dagoodma/SLUGS-Logger/Hardware/SLogger.brd

## EAGLE design Hardware/SLogger.brd (2015-04-01)

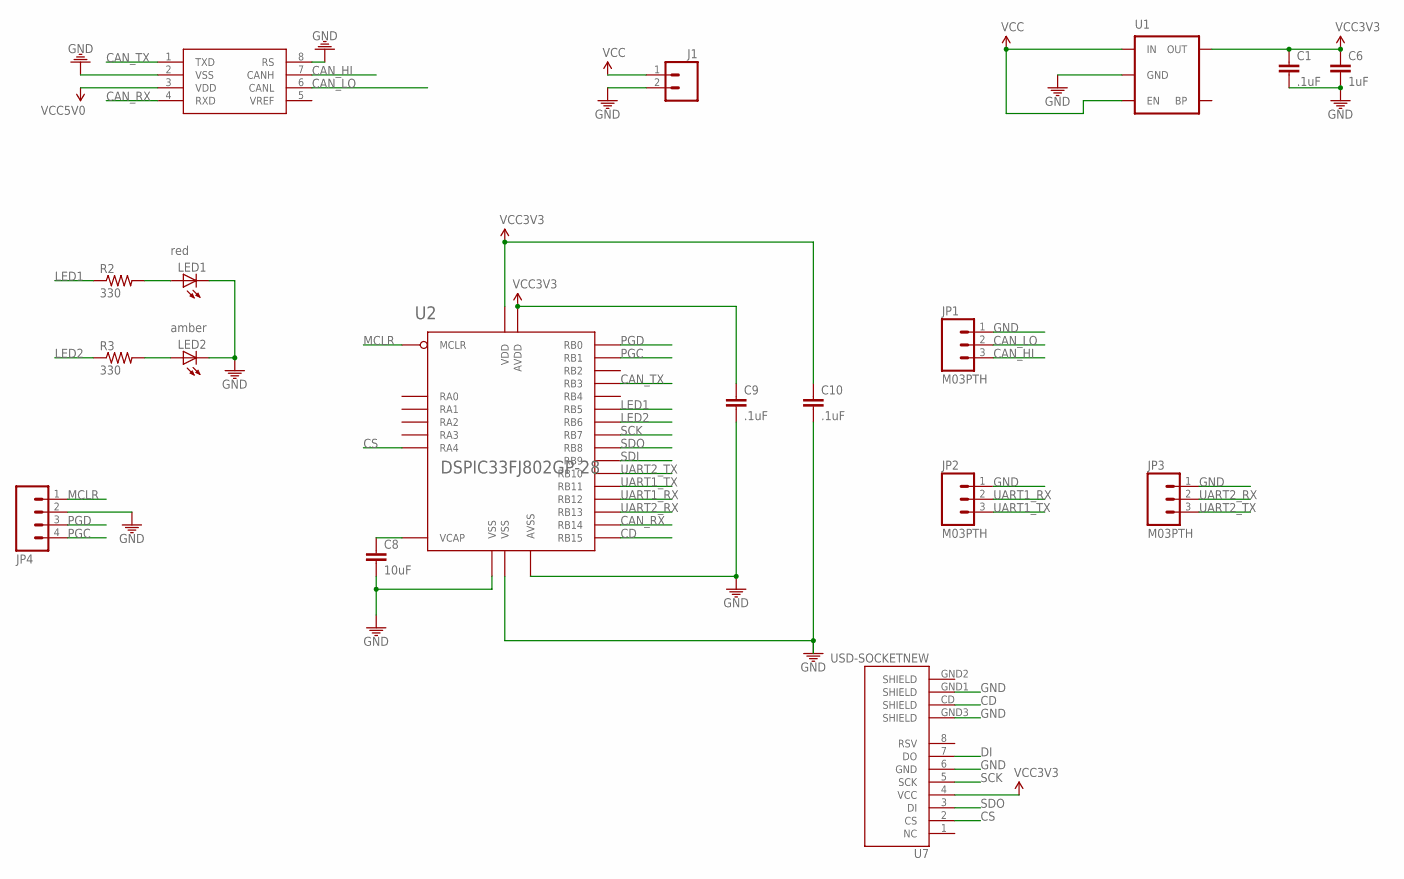
[picture p2: schematic SLogger.sch]

Parts:
C1, C9, C10: .1uF; 0805
C6: 1uF; 0805
C8: 10uF; 0805
J1: M02PTH; 1X02
JP1, JP2, JP3: M03PTH; 1X03
JP4: M04PTH; 1X04
LED1, LED2: LED0805; LED-0805
R2, R3: 330; 0805
U1: MIC52053.3V; SOT23-5
U2: DSPIC33FJ802GP-28; SOIC28-W
U4: MCP2551; SO08
U7: USD-SOCKETNEW; MICRO-SD-SOCKET-PP

Connections:
CAN_HI: JP1.3, U4.7 (CANH)
CAN_LO: JP1.2, U4.6 (CANL)
CAN_RX: U2.P$25 (RB14), U4.4 (RXD)
CAN_TX: U2.P$7 (RB3), U4.1 (TXD)
CD: U2.P$26 (RB15), U7.CD (SHIELD)
CS: U2.P$12 (RA4), U7.2 (CS)
DI: U7.7 (DO)
GND: C1.2, C6.2, C8.2, C9.2, C10.2, J1.2 (1), JP1.1, JP2.1, JP3.1, JP4.2, LED1.2 (C), LED2.2 (C), U1.2 (GND), U2.P$8 (VSS), U2.P$19 (VSS), U2.P$27 (AVSS), U4.2 (VSS), U4.8 (RS), U7.6 (GND), U7.GND1 (SHIELD), U7.GND3 (SHIELD)
LED1: R2.1, U2.P$14 (RB5)
LED2: R3.1, U2.P$15 (RB6)
MCLR: JP4.1, U2.P$1 (MCLR)
unnamed: LED1.1 (A), R2.2
unnamed: LED2.1 (A), R3.2
unnamed: C8.1, U2.P$20 (VCAP)
PGC: JP4.4, U2.P$5 (RB1)
PGD: JP4.3, U2.P$4 (RB0)
SCK: U2.P$16 (RB7), U7.5 (SCK)
SDI: U2.P$18 (RB9)
SDO: U2.P$17 (RB8), U7.3 (DI)
UART1_RX: JP2.2, U2.P$23 (RB12)
UART1_TX: JP2.3, U2.P$22 (RB11)
UART2_RX: JP3.2, U2.P$24 (RB13)
UART2_TX: JP3.3, U2.P$21 (RB10)
VCC: J1.1 (2), U1.1 (IN), U1.3 (EN)
VCC3V3: C1.1, C6.1, C9.1, C10.1, U1.5 (OUT), U2.P$13 (VDD), U2.P$28 (AVDD), U7.4 (VCC)
VCC5V0: U4.3 (VDD)

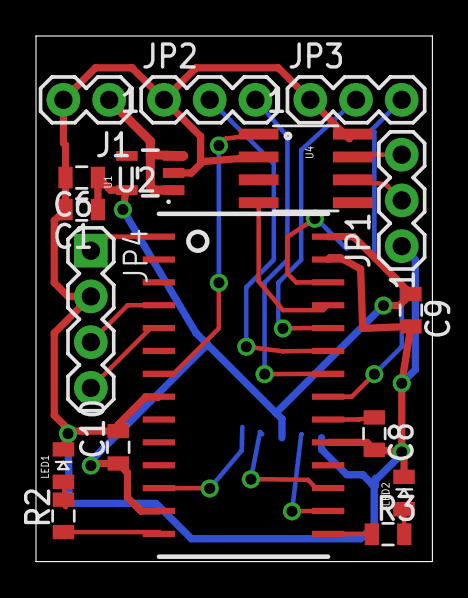
[picture p3: board SLogger.brd from above]

Board: 2 copper layers, 22.0 x 29.2 mm, 18 parts (1 on the bottom side), 23 nets.
