dagoodma/SLUGS-Logger/Testing/README.txt

Various test files:
beotest.txt - A few minutes to transmit @ 115200baud. Good initial test.
beotest_*sectors.txt - For debugging specific problems.
LotsOfLiterature.txt - Takes ~30 minutes to transmit at 115200 baud. If this works well, chances are the datalogger will work fine.
