dagoodma/SLUGS-Logger/HardwareProfile.h

/******************************************************************************
 *
 *                Microchip Memory Disk Drive File System
 *
 ******************************************************************************
 * FileName:        HardwareProfile.h
 * Dependencies:    None
 * Processor:       PIC18/PIC24/dsPIC30/dsPIC33/PIC32
 * Compiler:        C18/C30/C32
 * Company:         Microchip Technology, Inc.
 *
 * Software License Agreement
 *
 * The software supplied herewith by Microchip Technology Incorporated
 * (the ?Company?) for its PICmicro? Microcontroller is intended and
 * supplied to you, the Company?s customer, for use solely and
 * exclusively on Microchip PICmicro Microcontroller products. The
 * software is owned by the Company and/or its supplier, and is
 * protected under applicable copyright laws. All rights are reserved.
 * Any use in violation of the foregoing restrictions may subject the
 * user to criminal sanctions under applicable laws, as well as to
 * civil liability for the breach of the terms and conditions of this
 * license.
 *
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
*****************************************************************************/
/********************************************************************
 Change History:
  Rev            Description
  ----           -----------------------
  1.3.4          Added support for PIC18F8722,PIC24FJ256DA210,
                 dsPIC33E & PIC24E microcontrollers.
                 Added macro "SPI_INTERRUPT_FLAG_ASM" for PIC18F
                 microcontrollers to support SD card SPI driver.
********************************************************************/

#ifndef HARDWAREPROFILE_H_
#define HARDWAREPROFILE_H_

// Make sure Microchip's libraries know they're using the SPI-SD interface
#define USE_SD_INTERFACE_WITH_SPI

#if defined (__dsPIC33E__) || defined (__PIC24E__)

    #define GetSystemClock()        80000000
    #define GetPeripheralClock()    (GetSystemClock() / 2)
    #define GetInstructionClock()   (GetSystemClock() / 2)

    // Description: SD-SPI Chip Select Output bit
    #define SD_CS               PORTBbits.RB0
    // Description: SD-SPI Chip Select TRIS bit
    #define SD_CS_TRIS          TRISBbits.TRISB0

    // Description: SD-SPI Analog/Digital Select ANSEL bit
    #define SD_CS_ANSEL		0   //ANSELBbits.ANSB9

    // Description: SD-SPI Card Detect Input bit
    // The state of the SD card, 0 means that the SD card is inserted.
    #define SD_CD               PORTAbits.RA0
    // Description: SD-SPI Card Detect TRIS bit
    #define SD_CD_TRIS          TRISAbits.TRISA0

    // Description: SD-SPI Write Protect Check Input bit
    #define SD_WE               0
    // Description: SD-SPI Write Protect Check TRIS bit
    #define SD_WE_TRIS          TRISAbits.TRISA2

    // Description: SD-SPI Analog/Digital Select ANSEL bit
    #define SD_SCK_ANSEL	0   //ANSELGbits.ANSG6
    #define SD_SDI_ANSEL	0   //ANSELGbits.ANSG7
    #define SD_SDO_ANSEL	0   //ANSELGbits.ANSG8

    // Description: The main SPI control register
    #define SPICON1             SPI2CON1
    // Description: The SPI status register
    #define SPISTAT             SPI2STAT
    // Description: The SPI Buffer
    #define SPIBUF              SPI2BUF
    // Description: The receive buffer full bit in the SPI status register
    #define SPISTAT_RBF         SPI2STATbits.SPIRBF
    // Description: The bitwise define for the SPI control register (i.e. _____bits)
    #define SPICON1bits         SPI2CON1bits
    // Description: The bitwise define for the SPI status register (i.e. _____bits)
    #define SPISTATbits         SPI2STATbits
    // Description: The enable bit for the SPI module
    #define SPIENABLE           SPI2STATbits.SPIEN
    // Description: The definition for the SPI baud rate generator register
    #define SPIBRG              0 // SPI2BRG

    // Tris pins for SCK/SDI/SDO lines

    // Description: The TRIS bit for the SCK pin
    #define SPICLOCK            TRISBbits.TRISB9
    // Description: The TRIS bit for the SDI pin
    #define SPIIN               TRISBbits.TRISB14
    // Description: The TRIS bit for the SDO pin
    #define SPIOUT              TRISBbits.TRISB8

#else

    #error Only the dsPIC33E/PIC24Es are supported with this hardware profile

#endif

#endif // HARDWAREPROFILE_H_
