dagoodma/SLUGS-Logger/(commit log)

2013-02-19 Getting used to UART. This does simply receive using DMA.
2013-02-19 Put UART init and interrupt into Uart2.c and Uart2.h
2013-02-19 Put DMA stuff with Uart2 library. DMA is now in ping-pong mode.
2013-02-19 Finished ping-pong buffer with user-defined interrupt func. Uart2Init() now takes a user-defined function pointer which is called when a pin-pong buffer is full. main.c has an example.
2013-02-22 Plugged old SPI and Filesystem stuff into new UART using OFBProxy to give Service_SPI() something to use.
2013-03-02 Added a single-shot sector-write function which does not currently work.
2013-03-05 NewSDWriteSector now works correctly. This easily allows writing a single sectors at a time to a file.
    [NewSDWrite.h, main.c]
2013-03-05 Added new SDWrite functions to more versatile. They don't currently work. Updated the todo list.
2013-03-05 NewSDWriteSector and NewSDInit now work correctly using the function NewFileUpdate which mimics FSfclose.
    [NewSDWrite.h, main.c]
2013-03-06 Reworked file orgnization, removed unused files, removed some unused functions.
    [main.c]
2013-03-06 More reworking of file system. Redownloaded Microchip lib and removed all old library code.
    [FSconfig.h, HardwareProfile.h, main.c]
2013-03-06 Implemented Bryant's circular buffer to work with the UART. It kinda works. Only writes up to 33kb.
2013-03-06 Still getting 33k error, now has debug code. Added debug folder with interesting UART output. Seems there is a problem transitioning between clusters.
    [main.c]
2013-03-07 33k bug is because of incorrect cluster switching.
2013-03-12 Fixed 33k bug - now correctly switches to a new cluster when needed.
2013-03-12 Can write continuously (tested 2.5 MB at full speed). Removing SD card causes all following writes to fail even if the card is put back.
    [main.c]
2013-03-15 Tested multiple times - each test had indentical errors. Now 38400 baud, removed some debug code.
    [main.c]
2013-03-15 Generates own data for putting on the circular buffer. Added more debug notes - a clear pattern was found. Not a problem with serial, DMA, or speed. See third debug note.
    [main.c]
2013-03-20 Continued testing to fix circular buffer bug - it is more complicated than expected. Created a python script to confirm a repeating text file.
    [main.c]
2013-04-01 Fixed circular buffer bug, added tests to verify.
    [main.c]
2013-04-08 Added checksums on the input and output of the circ buff. There is still a problem with reading from the circ buff.
    [main.c]
2013-04-10 Might have fixed the circular buffer problem. Lots of debug code to clean up.
    [main.c]
2013-04-15 Corrected the circular buffer size for a proper test.
    [main.c]
2013-04-26 Started implementing config file. Doesn't work.'
    [main.c]
2013-05-13 Fixed address/stack error when disconnecting card. Was dereferencing a null pointer. Now checks for null.
    [Traps.c, main.c]
2013-05-20 Now compiles for the CANode, but does not work, likely due to a mistake in the uSD shield.
    [HardwareProfile.h, main.c]
2013-06-03 Switched the test sender to a CANode, now everything works fine. Next: UART tests on the CANode.
2013-06-04 There seems to be problems with creating files with the correct names and with the device restarting when the 8GB card is inserted.
    [main.c]
2013-07-01 Opening files is having problems - I implemented basic EEPROM emulation.
    [main.c]
2013-07-02 File writing works with basic tests - file headers and footers are now correct.
    [main.c]
2013-07-30 UART works now
2013-08-02 Working on fixing the SPI pins.
    [HardwareProfile.h, main.c]
2013-08-02 SPI seems to work, removed some stuff that didn't need to be tracked.
    [main.c]
2013-08-06 Code is not working or debugging on the main project. Commiting before making drastic changes.
    [main.c]
2013-08-07 UART/DMA seems to work, testing now.
2013-08-08 Made buffer much smaller to hopefully keep the stack out of extended data space. DMA address error soft trap is triggering.
    [main.c]
2013-08-13 Added a doc and tried fixing some of the warnings.
    [main.c]
2013-08-14 Added an assembly file to put the stack in regular data space and changed Traps.c
2013-08-14 Increased the buffer and did a short test.
    [main.c]
2013-08-15 Isolated a bug with the DEE.
    [main.c]
2013-08-16 Added debug output over the UART, cleaned up some code, added to the REAME, and did a test.
2014-10-07 Hardware has inverted card detect signal.
    [HardwareProfile.h]
2014-10-07 Various improvements and cleanups. Red LED now works. Code is organized a little better. Some dead code removed.
2014-10-08 Remove old debugging code. Add LED status blinking.
    Now the amber LED turns off whenever data is received, for a brief point of time. This allows for simple debugging in the field: if the LED isn't blinking, the data isn't being received. And if the SD card isn't receiving files, then there's a problem with the output.
    [main.c]
2014-10-08 Light the red LED on startup until the card is initialized.
2014-11-04 Make UART2 pin assignment dependent on configuration settings.
2014-11-04 Only support a single SD-card pin layout.
2014-11-05 Allow for peripheral pin configuration multiple times.
2014-11-05 Replace FATAL_ERROR() macro with one that blinks the red LED.
    This makes it more clean when the startup LED is solid at startup and when it
    runs into a fatal error later on during initialization.
    [main.c]
2014-11-06 Add a delay when triggering on card insertion to make sure it's not a glitch.
    [main.c]
2014-11-06 Add Uart2Disable() function.
2014-11-06 Disable UART2 when the card is removed.
2014-11-06 Support logging metadata to an additional file.
    Preliminary support added for power-up and config settings.
    Also fix for improper const variable.
    [main.c]
2014-11-07 Add a .1s precision timer for logging events.
    And make sure the event trackers are reset everything the card is reinitialized.
    [main.c]
2014-11-07 Reorder initialization to prevent bufer overflow.
    [main.c]
2014-11-07 Log why a new log file was created.
    Currently tracking if it was a power-on event, card insertion, brown-out, manual reset, or a cat
    ch-all for other unknown events.
    [main.c]
2014-11-07 Remove infinite loops that can stall initialization from the SPI lib.
2014-11-07 Reduce timeout limit in the SPI library.
2014-11-07 Disable the UART when the SD card is removed.
2014-11-07 Change some FATAL_ERRORs into recoverable errors.
    Most errors should be reset once the SDcard is removed and reinserted.
    We just need to make sure that things are reset properly.
    [main.c]
2015-03-14 Switch status LED to blink @1Hz when normal and 2Hz when receiving data.
2015-03-29 First draft of datalogger hardware board.
    [SLogger.brd, SLogger.sch]
2015-04-01 Finished 1.0 version of the new SLogger hardware.
    [SLogger.brd, SLogger.sch]
